LGsekara1/Robotnik/final_robot/Pinout.MD

## Pinout
## Motor Controllers
- LDriver - LPWM = 9, RPWM = 10
- RDriver - LPWM = 6, RPWM = 7

## Encoders
- L1 (yellow) = 3, L2 (green) = 2
- R1 (yellow) = 18, R2 (green) = 19

## IR array (Raykha- S8)
22 to 29

## TOF sensors
XSHUT[1,6] = 41,40,43,42,45,44
