LGsekara1/Robotnik/media/Robtot_in_action.jpeg

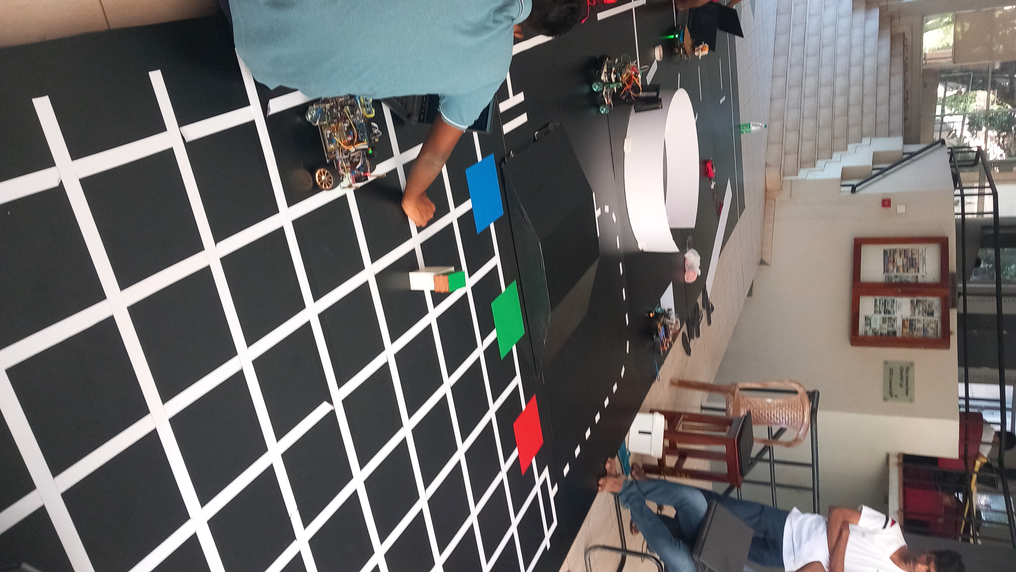
media/Robtot_in_action.jpeg
