LGsekara1/Robotnik/TestRobot/IR array QTR8RC/QTR-8A-Pinout.webp

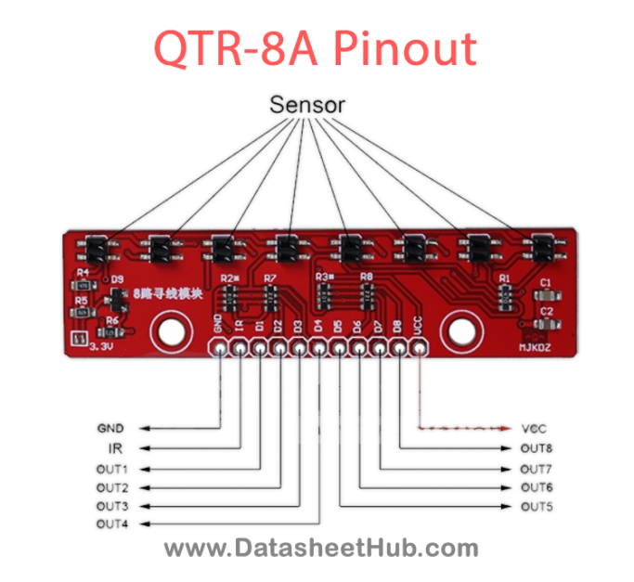
TestRobot/IR array QTR8RC/QTR-8A-Pinout.webp
