LGsekara1/Robotnik/TestRobot/JGA25-370 gear motor with encoder/Readme.MD

## JGA25-370 gear motor with encoder datasheet
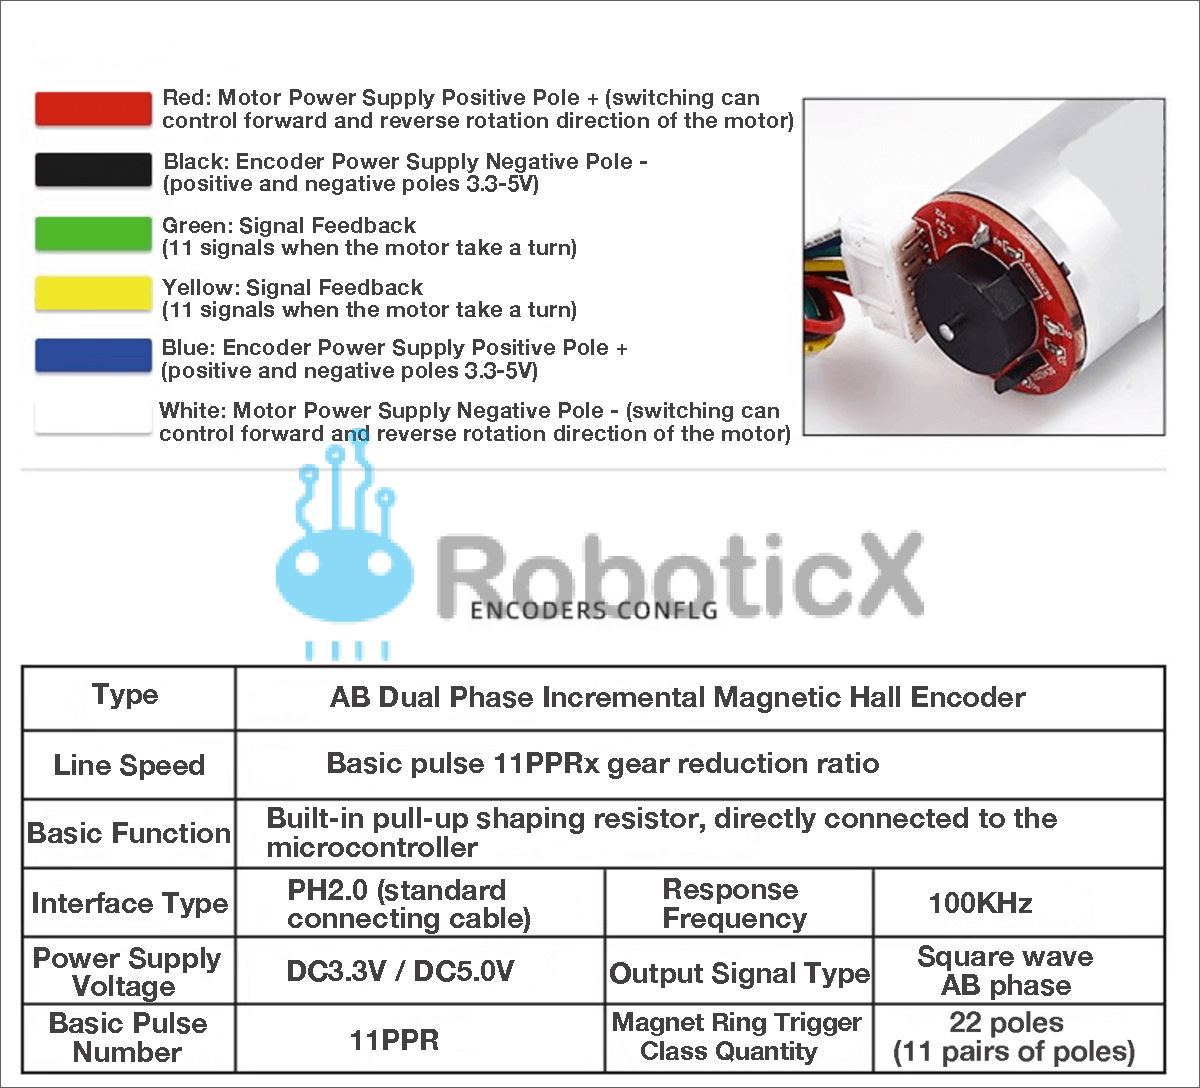
[picture p15: TestRobot/JGA25-370 gear motor with encoder/NFP-JGA25-370-EN-gear-motor-encoder-wiring-tips.jpg]
Encoder data
