LGsekara1/Robotnik/TestRobot/Arduino pins for sensors.MD

# Motor driver:

  * LPWM - Purple
  * RPWM - Bluw
  * R_EN - White
  * L_EN - Brown
  * VCC - Red
  * GND - Black

# Sharp IR:

# QTR8RC IR array:

# ULtra sound:
