LGsekara1/Robotnik/TestRobot/SharpIR tseting/Readme.MD

# Sharp IR pinout
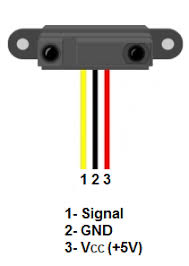
[picture p16: TestRobot/SharpIR tseting/SharpIR.jpeg]
SharpIR
