LGsekara1/Robotnik/final_robot/Final Robotnik/src/armServo.h

#ifndef ARM_SERVO_H
#define ARM_SERVO_H
#include <Arduino.h>
// #include <Servo.h>

void setupServo();
void getBox();
void releaseBox();
void grabBox();

void ballVerticalUp();
void ballVerticalDown();
void ballCylinderIn();
void ballCylinderOut();
void ballHorizontalIn();
void ballHorizontalOut();
// void ballHorizontalAdjust();

void runBallPicker();
void pickBall();
void endBallPicker();


#endif
