LGsekara1/Robotnik/final_robot/Final Robotnik/src/color.h

#ifndef COLOR_H
#define COLOR_H

#include <Arduino.h>

extern int color;

void setupColor();
int readColor(int color_sensor_number);
void calibrateColor();

#endif










// #ifndef COLOR_H
// #define COLOR_H

// #include <Arduino.h>

// extern int color;

// void setupColor();
// void readColor(int color_sensor_number);

// #endif
