LGsekara1/Robotnik/final_robot/Final Robotnik/src/task5.cpp

#include "task5.h"
#include "lineFollowing.h"
#include "ir.h"
#include "motion.h"


void Task5(){
    char arrow_direction[10] = {'R', 'R', 'R', 'R', 'L', 'L', 'R', 'R', 'R', 'R'};
    // int arrow_angle[10] = {0, 90, 30, 240, 15, 70, 40, 80, 50, 15};
    // int arrow_angle2[10]={0, 90, 30, 240, };
    int arrowCount=0;

    while(true){
        runLineFollower(70,70);
        readIR();
        if (allOnes(ir_values,8)==1){
            if (arrowCount==0 || arrowCount==9 || arrowCount==10)startMotors(70,70);
            else if (arrowCount==3)startMotors(55,85);
            else if (arrowCount==8)startMotors(90,50);
            else if (arrow_direction[arrowCount]=='R')startMotors(85,55);
            else startMotors(65,85);
            while(true){
                readIR();
                if (isNextNode()){
                    if (arrowCount==10){stopMotors();return;} 
                    goDistance(120,70);
                    // rotateRobot(arrow_direction[arrowCount],arrow_angle[arrowCount]);
                    turnUntilLine(arrow_direction[arrowCount]);
                    arrowCount++;
                    break;}
            }
            // if (arrowCount==11){break;}
        }
    }
}






// void Task5_prev(){
//     char arrow_direction[10] = {'R', 'R', 'R', 'L', 'L', 'L', 'R', 'R', 'R', 'R'};
//     int arrow_angle[10] = {0, 90, 30, 120, 15, 70, 40, 80, 50, 15};
//     int arrowCount=0;

//     while(true){
//         runLineFollower(70,70);
//         readIR();
//         if (allOnes(ir_values,8)==1){
//             if (arrowCount==0)startMotors(70,70);
//             else if (arrow_direction[arrowCount]=='R')startMotors(80,60);
//             else startMotors(60,80);
//             while(true){
//                 readIR();
//                 if (isNextNode()){
//                     goDistance(120,70);
//                     rotateRobot(arrow_direction[arrowCount],arrow_angle[arrowCount]);
//                     arrowCount++;
//                     break;}
//             }
//             if (arrowCount==11)break;
//         }
//     }
// }
