LGsekara1/Robotnik/final_robot/Final Robotnik/src/display.h

#ifndef DISPLAY_H
#define DISPLAY_H

#include <Adafruit_SSD1306.h>

extern bool display_ok;

void setupDisplay();
void showDisplay(String text, int textSize, int x=0, int y=0);
void clearDisplay();

#endif
