LGsekara1/Robotnik/final_robot/Final Robotnik/src/lineFollowing.h

#ifndef LINE_FOLLOWING_H
#define LINE_FOLLOWING_H

#include <Arduino.h>

void runLineFollower(int LINE_BASE_SPEED = 100 , int tolerance = 100 );

#endif




// #ifndef LINE_FOLLOWING_H
// #define LINE_FOLLOWING_H

// #include <Arduino.h>

// void runLineFollower();

// #endif
