LGsekara1/Robotnik/TestRobot/JGA25-370 gear motor with encoder/encoder_test/encoder_test.ino

#define ENCA 2
#define ENCB 3

volatile long encoderPos = 0; // Position counter

void setup() {
  Serial.begin(9600);
  pinMode(ENCA, INPUT);
  pinMode(ENCB, INPUT);

  attachInterrupt(digitalPinToInterrupt(ENCA), readEncoder, CHANGE);
}

void loop() {
  Serial.println(encoderPos);
  delay(50);
}

void readEncoder() {
  int a = digitalRead(ENCA);
  int b = digitalRead(ENCB);

  if (a == b) {
    encoderPos++; // CW
  } else {
    encoderPos--; // CCW
  }
}
