LGsekara1/Robotnik/(commit log)

2025-08-06 Create Readme for encoder.MD
2025-08-06 Motor driver pins update commit
2025-08-06 Update Arduino pins for sensors.MD
2025-08-19 Motor driver test commit
2025-08-24 Pin change commit
    IR array order was reversed
    [QTR_Analog.ino, motor_driver.ino]
2025-11-29 Arduino.h error fix commit
2025-12-26 CAD media update commit
